pinanshu123/High-Speed-USB-2.0-Storage-Device-PCB/High-Speed USB 2.0 Storage Device PCB-Board.kicad_pcb

## KiCad design High-Speed USB 2.0 Storage Device PCB-Board.kicad_pcb (2026-09-08)

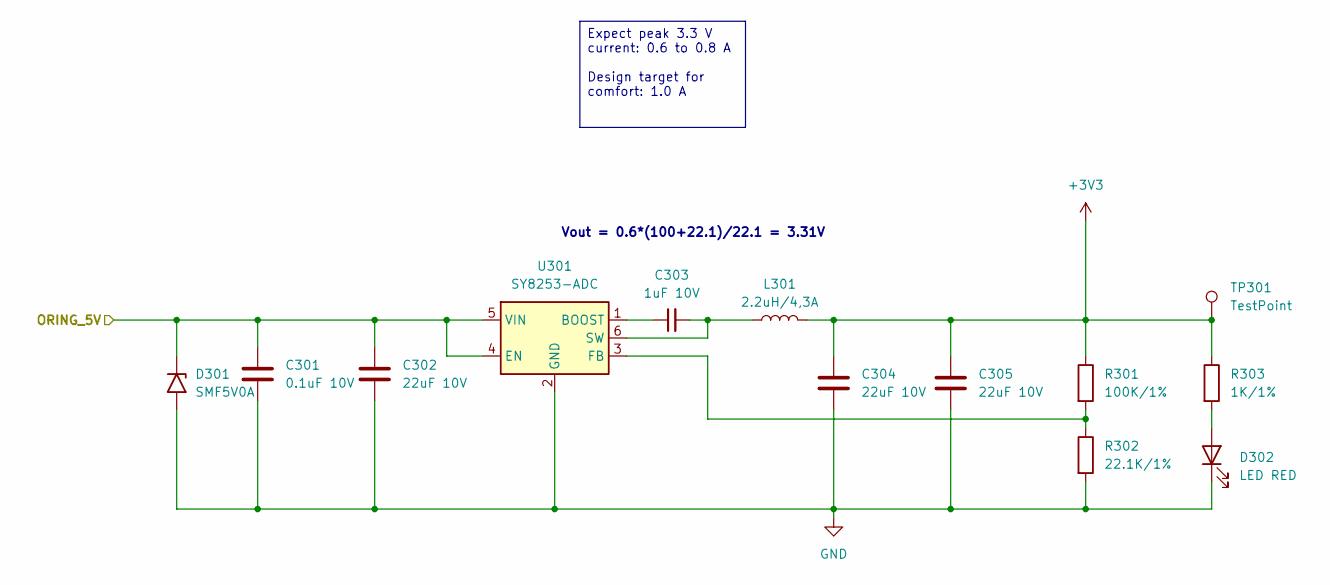
[picture p1: schematic buck_converter_power.kicad_sch, USB Smart Storage]

Parts:
C301: 0.1uF 10V; C_0402_1005Metric
C302: 22uF 10V; C_0805_2012Metric_Pad1.18x1.45mm_HandSolder
C303: 1uF 10V; C_0402_1005Metric
C304, C305: 22uF 10V; C_0805_2012Metric
D301: SMF5V0A; D_SMF
D302: LED RED; LED_0603_1608Metric
L301: 2.2uH/4,3A; L_Sunlord_SWPA4020S
R301: 100K/1%; R_01005_0402Metric
R302: 22.1K/1%; R_01005_0402Metric
R303: 1K/1%; R_01005_0402Metric
TP301: TestPoint; TestPoint_Pad_D1.5mm
U301: SY8253-ADC; TSOT-23-6

Connections:
+3V3: C304.1, C305.1, L301.2, R301.1, R303.1, TP301.1 (1_1); also elsewhere on the board
/ORING_POWER/ORING_5V: C301.1, C302.1, D301.1 (A1), U301.4 (EN), U301.5 (VIN); also elsewhere on the board
GND: C301.2, C302.2, C304.2, C305.2, D301.2 (A2), D302.1 (K), R302.2, U301.2 (GND); also elsewhere on the board
unnamed: D302.2 (A), R303.2
unnamed: C303.1, U301.1 (BOOST)
unnamed: R301.2, R302.1, U301.3 (FB)
unnamed: C303.2, L301.1, U301.6 (SW)

Notes on the sheet:
Vout = 0.6*(100+22.1)/22.1 = 3.31V
Expect peak 3.3 V current: 0.6 to 0.8 A Design target for comfort: 1.0 A

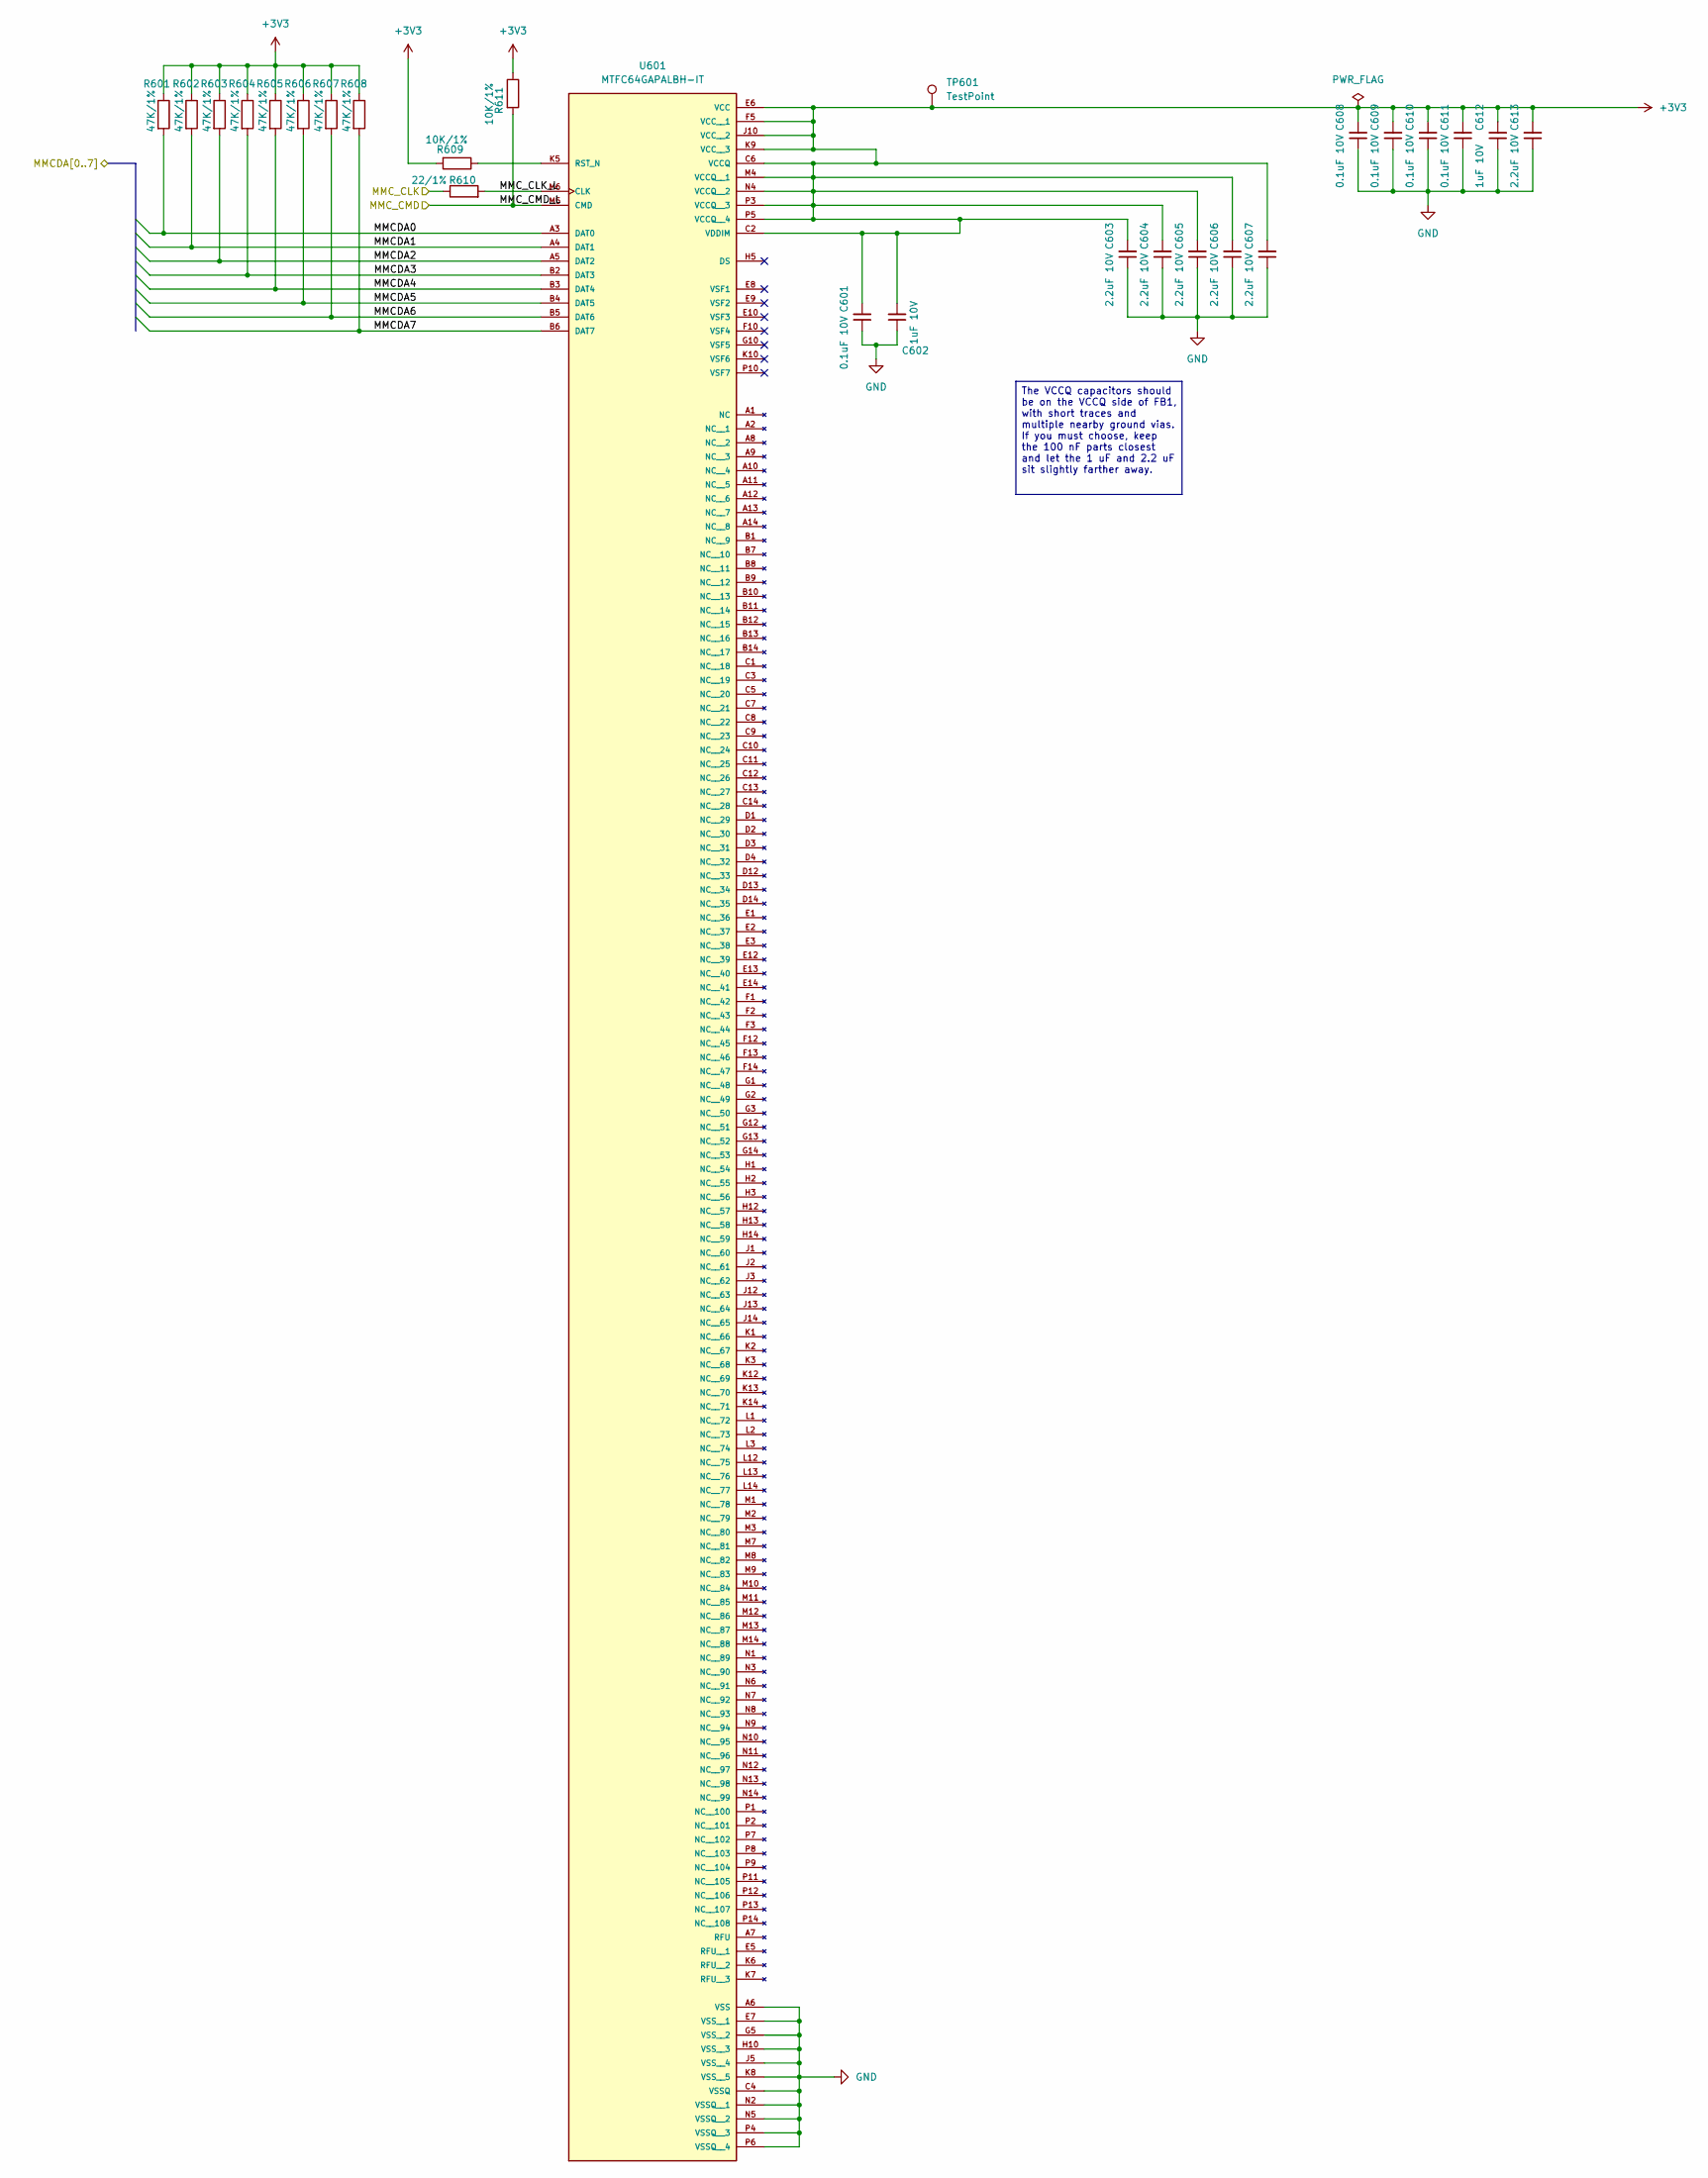
[picture p2: schematic emmc_storage.kicad_sch, USB Smart Storage]

Parts:
C601, C608, C609, C610, C611: 0.1uF 10V; C_0402_1005Metric
C602, C612: 1uF 10V; C_0402_1005Metric
C603, C604, C605, C606, C607, C613: 2.2uF 10V; C_0402_1005Metric
R601, R602, R603, R604, R605, R606, R607, R608: 47K/1%; R_01005_0402Metric
R609, R611: 10K/1%; R_01005_0402Metric
R610: 22/1%; R_01005_0402Metric
TP601: TestPoint; TestPoint_Pad_D1.5mm
U601: MTFC64GAPALBH-IT; BGA153N50P14X14_1300X1150X110N; PARTREV Rev. C 3/19 EN

Connections:
+3V3: C601.2, C602.2, C603.2, C604.2, C605.2, C606.2, C607.2, C608.2, C609.2, C610.2, C611.2, C612.2, C613.2, R601.1, R602.1, R603.1, R604.1, R605.1, R606.1, R607.1, R608.1, R609.2, R611.1, TP601.1 (1_1), U601.C2 (VDDIM), U601.C6 (VCCQ), U601.E6 (VCC), U601.F5 (VCC__1), U601.J10 (VCC__2), U601.K9 (VCC__3), U601.M4 (VCCQ__1), U601.N4 (VCCQ__2), U601.P3 (VCCQ__3), U601.P5 (VCCQ__4); also elsewhere on the board
/USB_BRIDGE/MMCD0: R601.2, U601.A3 (DAT0); also elsewhere on the board
/USB_BRIDGE/MMCD1: R602.2, U601.A4 (DAT1); also elsewhere on the board
/USB_BRIDGE/MMCD2: R603.2, U601.A5 (DAT2); also elsewhere on the board
/USB_BRIDGE/MMCD3: R604.2, U601.B2 (DAT3); also elsewhere on the board
/USB_BRIDGE/MMCD4: R605.2, U601.B3 (DAT4); also elsewhere on the board
/USB_BRIDGE/MMCD5: R606.2, U601.B4 (DAT5); also elsewhere on the board
/USB_BRIDGE/MMCD6: R607.2, U601.B5 (DAT6); also elsewhere on the board
/USB_BRIDGE/MMCD7: R608.2, U601.B6 (DAT7); also elsewhere on the board
/USB_BRIDGE/MMC_CLK: R610.1; also elsewhere on the board
/eMMC_STORAGE/MMC_CLK_L: R610.2, U601.M6 (CLK)
/eMMC_STORAGE/MMC_CMD_L: R611.2, U601.M5 (CMD); also elsewhere on the board
GND: C601.1, C602.1, C603.1, C604.1, C605.1, C606.1, C607.1, C608.1, C609.1, C610.1, C611.1, C612.1, C613.1, U601.A6 (VSS), U601.C4 (VSSQ), U601.E7 (VSS__1), U601.G5 (VSS__2), U601.H10 (VSS__3), U601.J5 (VSS__4), U601.K8 (VSS__5), U601.N2 (VSSQ__1), U601.N5 (VSSQ__2), U601.P4 (VSSQ__3), U601.P6 (VSSQ__4); also elsewhere on the board
unnamed: R609.1, U601.K5 (RST_N)

Notes on the sheet:
The VCCQ capacitors should be on the VCCQ side of FB1, with short traces and multiple nearby ground vias. If you must choose, keep the 100 nF parts closest and let the 1 uF and 2.2 uF sit slightly farther away.

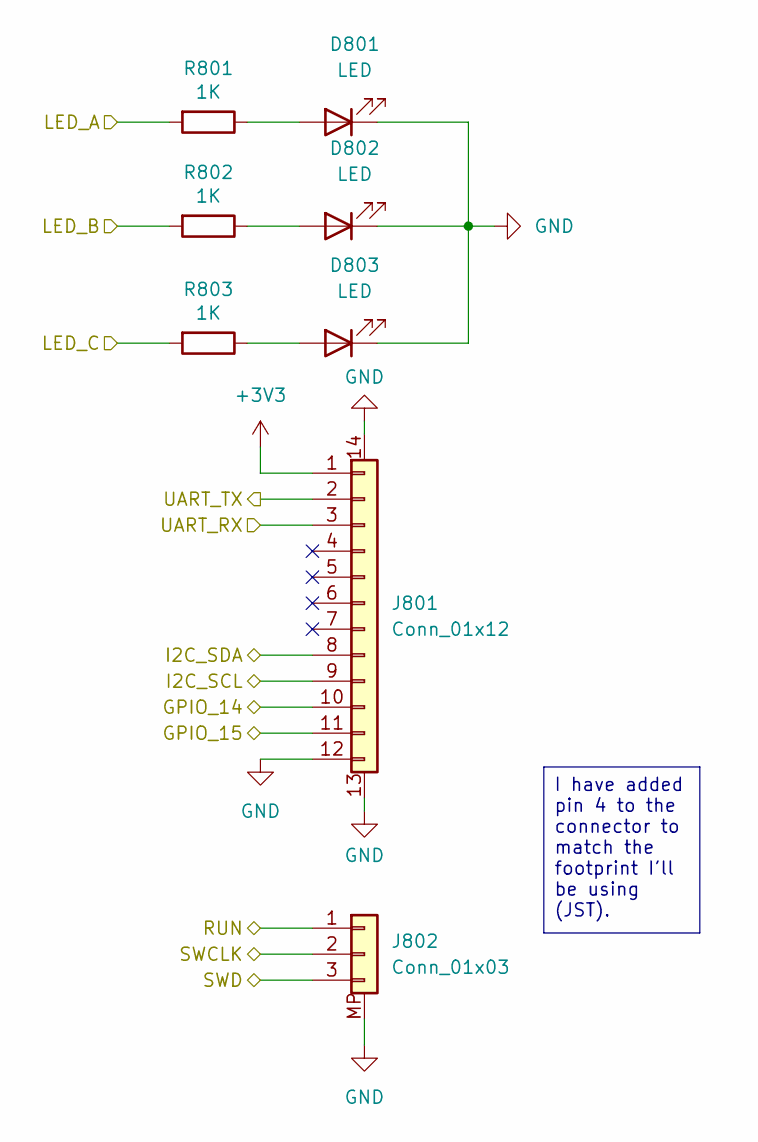
[picture p3: schematic gpio.kicad_sch, USB Smart Storage]

Parts:
D801, D802, D803: LED; LED_0603_1608Metric
J801: Conn_01x12; JST_SH_SM12B-SRSS-TB_1x12-1MP_P1.00mm_Horizontal
J802: Conn_01x03; JST_GH_SM03B-GHS-TB_1x03-1MP_P1.25mm_Horizontal
R801, R802, R803: 1K; R_0402_1005Metric

Connections:
+3V3: J801.1; also elsewhere on the board
/RP2040/GPIO_14: J801.10; also elsewhere on the board
/RP2040/GPIO_15: J801.11; also elsewhere on the board
/RP2040/I2C_SCL: J801.9; also elsewhere on the board
/RP2040/I2C_SDA: J801.8; also elsewhere on the board
/RP2040/LED_A: R801.2; also elsewhere on the board
/RP2040/LED_B: R802.2; also elsewhere on the board
/RP2040/LED_C: R803.2; also elsewhere on the board
/RP2040/RUN: J802.1; also elsewhere on the board
/RP2040/SWCLK: J802.2; also elsewhere on the board
/RP2040/SWD: J802.3; also elsewhere on the board
/RP2040/UART_RX: J801.3; also elsewhere on the board
/RP2040/UART_TX: J801.2; also elsewhere on the board
GND: D801.1 (K), D802.1 (K), D803.1 (K), J801.12, J801.13 (MP1), J801.14 (MP2), J802.MP; also elsewhere on the board
unnamed: D801.2 (A), R801.1
unnamed: D802.2 (A), R802.1
unnamed: D803.2 (A), R803.1

Notes on the sheet:
I have added pin 4 to the connector to match the footprint I'll be using (JST).

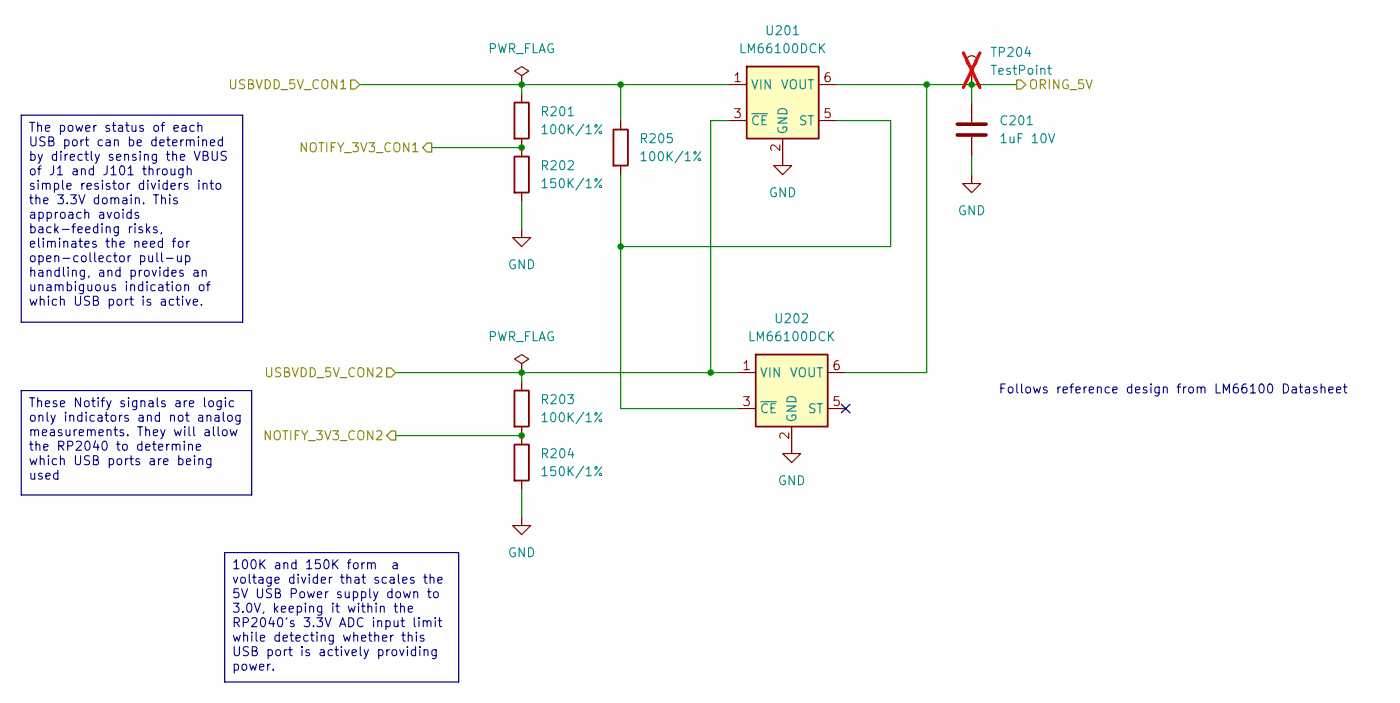
[picture p4: schematic oring_power.kicad_sch, USB Smart Storage]

Parts:
C201: 1uF 10V; C_0402_1005Metric
R201, R203, R205: 100K/1%; R_01005_0402Metric
R202, R204: 150K/1%; R_01005_0402Metric
TP204: TestPoint; TestPoint_Pad_D1.5mm; not fitted
U201, U202: LM66100DCK; SOT-363_SC-70-6

Connections:
/ORING_POWER/NOTIFY_3V3_CON1: R201.2, R202.1; also elsewhere on the board
/ORING_POWER/NOTIFY_3V3_CON2: R203.2, R204.1; also elsewhere on the board
/ORING_POWER/ORING_5V: C201.1, TP204.1, U201.6 (VOUT), U202.6 (VOUT); also elsewhere on the board
/VBUS_MCU: R203.1, U201.3 (~CE), U202.1 (VIN); also elsewhere on the board
/VBUS_STORAGE: R201.1, R205.1, U201.1 (VIN); also elsewhere on the board
GND: C201.2, R202.2, R204.2, U201.2 (GND), U202.2 (GND); also elsewhere on the board
unnamed: R205.2, U201.5 (ST), U202.3 (~CE)

Notes on the sheet:
Follows reference design from LM66100 Datasheet
100K and 150K form a voltage divider that scales the 5V USB Power supply down to 3.0V, keeping it within the RP2040's 3.3V ADC input limit while detecting whether this USB port is actively providing power.
These Notify signals are logic only indicators and not analog measurements. They will allow the RP2040 to determine which USB ports are being used
The power status of each USB port can be determined by directly sensing the VBUS of J1 and J101 through simple resistor dividers into the 3.3V domain. This approach avoids back-feeding risks, eliminates the need for open-collector pull-up handling, and provides an unambiguous indication of which US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

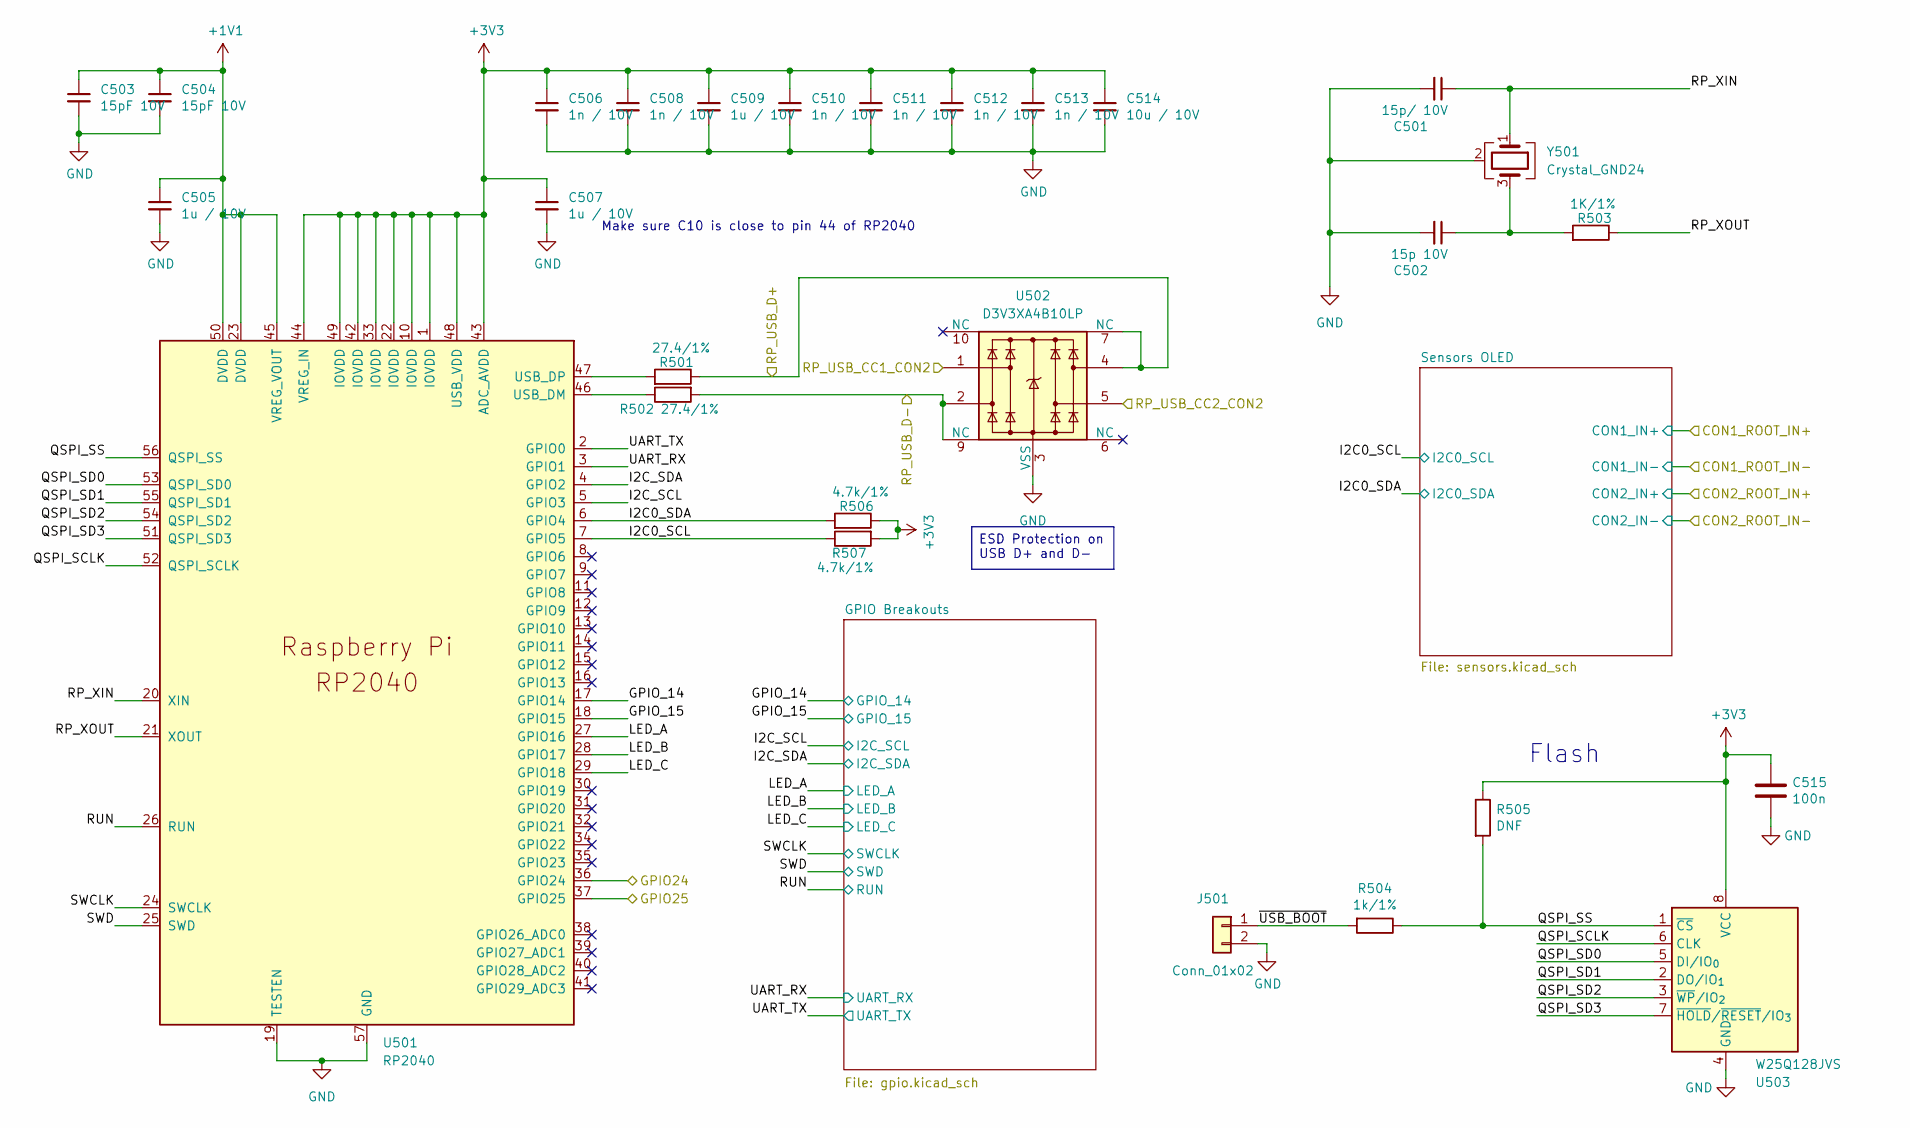
[picture p5: schematic rp2040.kicad_sch, USB Smart Storage]

Parts:
C501: 15p/ 10V; C_0402_1005Metric
C502: 15p 10V; C_0402_1005Metric
C503, C504: 15pF 10V; C_0402_1005Metric
C505, C507, C509: 1u / 10V; C_0402_1005Metric
C506, C508, C510, C511, C512, C513: 1n / 10V; C_0402_1005Metric
C514: 10u / 10V; C_0805_2012Metric
C515: 100n; C_0402_1005Metric
J501: Conn_01x02; PinHeader_1x02_P2.54mm_Vertical
R501, R502: 27.4/1%; R_01005_0402Metric
R503: 1K/1%; R_01005_0402Metric
R504: 1k/1%; R_0402_1005Metric
R505: DNF; R_0402_1005Metric
R506, R507: 4.7k/1%; R_01005_0402Metric
U501: RP2040; QFN-56-1EP_7x7mm_P0.4mm_EP3.2x3.2mm_ThermalVias
U502: D3V3XA4B10LP; Diodes_UDFN-10_1x2.5mm_P0.5mm
U503: W25Q128JVS; SOIC-8_5.3x5.3mm_P1.27mm
Y501: Crystal_GND24; Crystal_SMD_3225-4Pin_3.2x2.5mm

Connections:
+1V1: C503.1, C504.1, C505.1, U501.23 (DVDD), U501.45 (VREG_VOUT), U501.50 (DVDD)
+3V3: C506.1, C507.1, C508.1, C509.1, C510.1, C511.1, C512.1, C513.1, C514.1, C515.1, R505.1, R506.1, R507.2, U501.1 (IOVDD), U501.10 (IOVDD), U501.22 (IOVDD), U501.33 (IOVDD), U501.42 (IOVDD), U501.43 (ADC_AVDD), U501.44 (VREG_IN), U501.48 (USB_VDD), U501.49 (IOVDD), U503.8 (VCC); also elsewhere on the board
/ORING_POWER/NOTIFY_3V3_CON1: U501.37 (GPIO25); also elsewhere on the board
/ORING_POWER/NOTIFY_3V3_CON2: U501.36 (GPIO24); also elsewhere on the board
/RP2040/GPIO_14: U501.17 (GPIO14); also elsewhere on the board
/RP2040/GPIO_15: U501.18 (GPIO15); also elsewhere on the board
/RP2040/I2C0_SCL: R507.1, U501.7 (GPIO5); also elsewhere on the board
/RP2040/I2C0_SDA: R506.2, U501.6 (GPIO4); also elsewhere on the board
/RP2040/I2C_SCL: U501.5 (GPIO3); also elsewhere on the board
/RP2040/I2C_SDA: U501.4 (GPIO2); also elsewhere on the board
/RP2040/LED_A: U501.27 (GPIO16); also elsewhere on the board
/RP2040/LED_B: U501.28 (GPIO17); also elsewhere on the board
/RP2040/LED_C: U501.29 (GPIO18); also elsewhere on the board
/RP2040/QSPI_SCLK: U501.52 (QSPI_SCLK), U503.6 (CLK)
/RP2040/QSPI_SD0: U501.53 (QSPI_SD0), U503.5 (DI/IO_{0})
/RP2040/QSPI_SD1: U501.55 (QSPI_SD1), U503.2 (DO/IO_{1})
/RP2040/QSPI_SD2: U501.54 (QSPI_SD2), U503.3 (~WP/IO_{2})
/RP2040/QSPI_SD3: U501.51 (QSPI_SD3), U503.7 (~HOLD/~RESET/IO_{3})
/RP2040/QSPI_SS: R504.1, R505.2, U501.56 (QSPI_SS), U503.1 (~CS)
/RP2040/RP_USB_D+: R501.1, U502.4, U502.7 (NC); also elsewhere on the board
/RP2040/RP_USB_D-: R502.2, U502.2, U502.9 (NC); also elsewhere on the board
/RP2040/RP_XIN: C501.1, U501.20 (XIN), Y501.1
/RP2040/RP_XOUT: R503.1, U501.21 (XOUT)
/RP2040/RUN: U501.26 (RUN); also elsewhere on the board
/RP2040/SWCLK: U501.24 (SWCLK); also elsewhere on the board
/RP2040/SWD: U501.25 (SWD); also elsewhere on the board
/RP2040/UART_RX: U501.3 (GPIO1); also elsewhere on the board
/RP2040/UART_TX: U501.2 (GPIO0); also elsewhere on the board
/RP2040/~USB_BOOT: J501.1, R504.2
/USB_CC1_CON2: U502.1; also elsewhere on the board
/USB_CC2_CON2: U502.5; also elsewhere on the board
GND: C501.2, C502.2, C503.2, C504.2, C505.2, C506.2, C507.2, C508.2, C509.2, C510.2, C511.2, C512.2, C513.2, C514.2, C515.2, J501.2, U501.19 (TESTEN), U501.57 (GND), U502.3 (VSS), U502.8 (VSS), U503.4 (GND), Y501.2 (G), Y501.4 (G); also elsewhere on the board
unnamed: C502.1, R503.2, Y501.3
unnamed: R502.1, U501.46 (USB_DM)
unnamed: R501.2, U501.47 (USB_DP)

Notes on the sheet:
Flash
Make sure C10 is close to pin 44 of RP2040
ESD Protection on USB D+ and D-

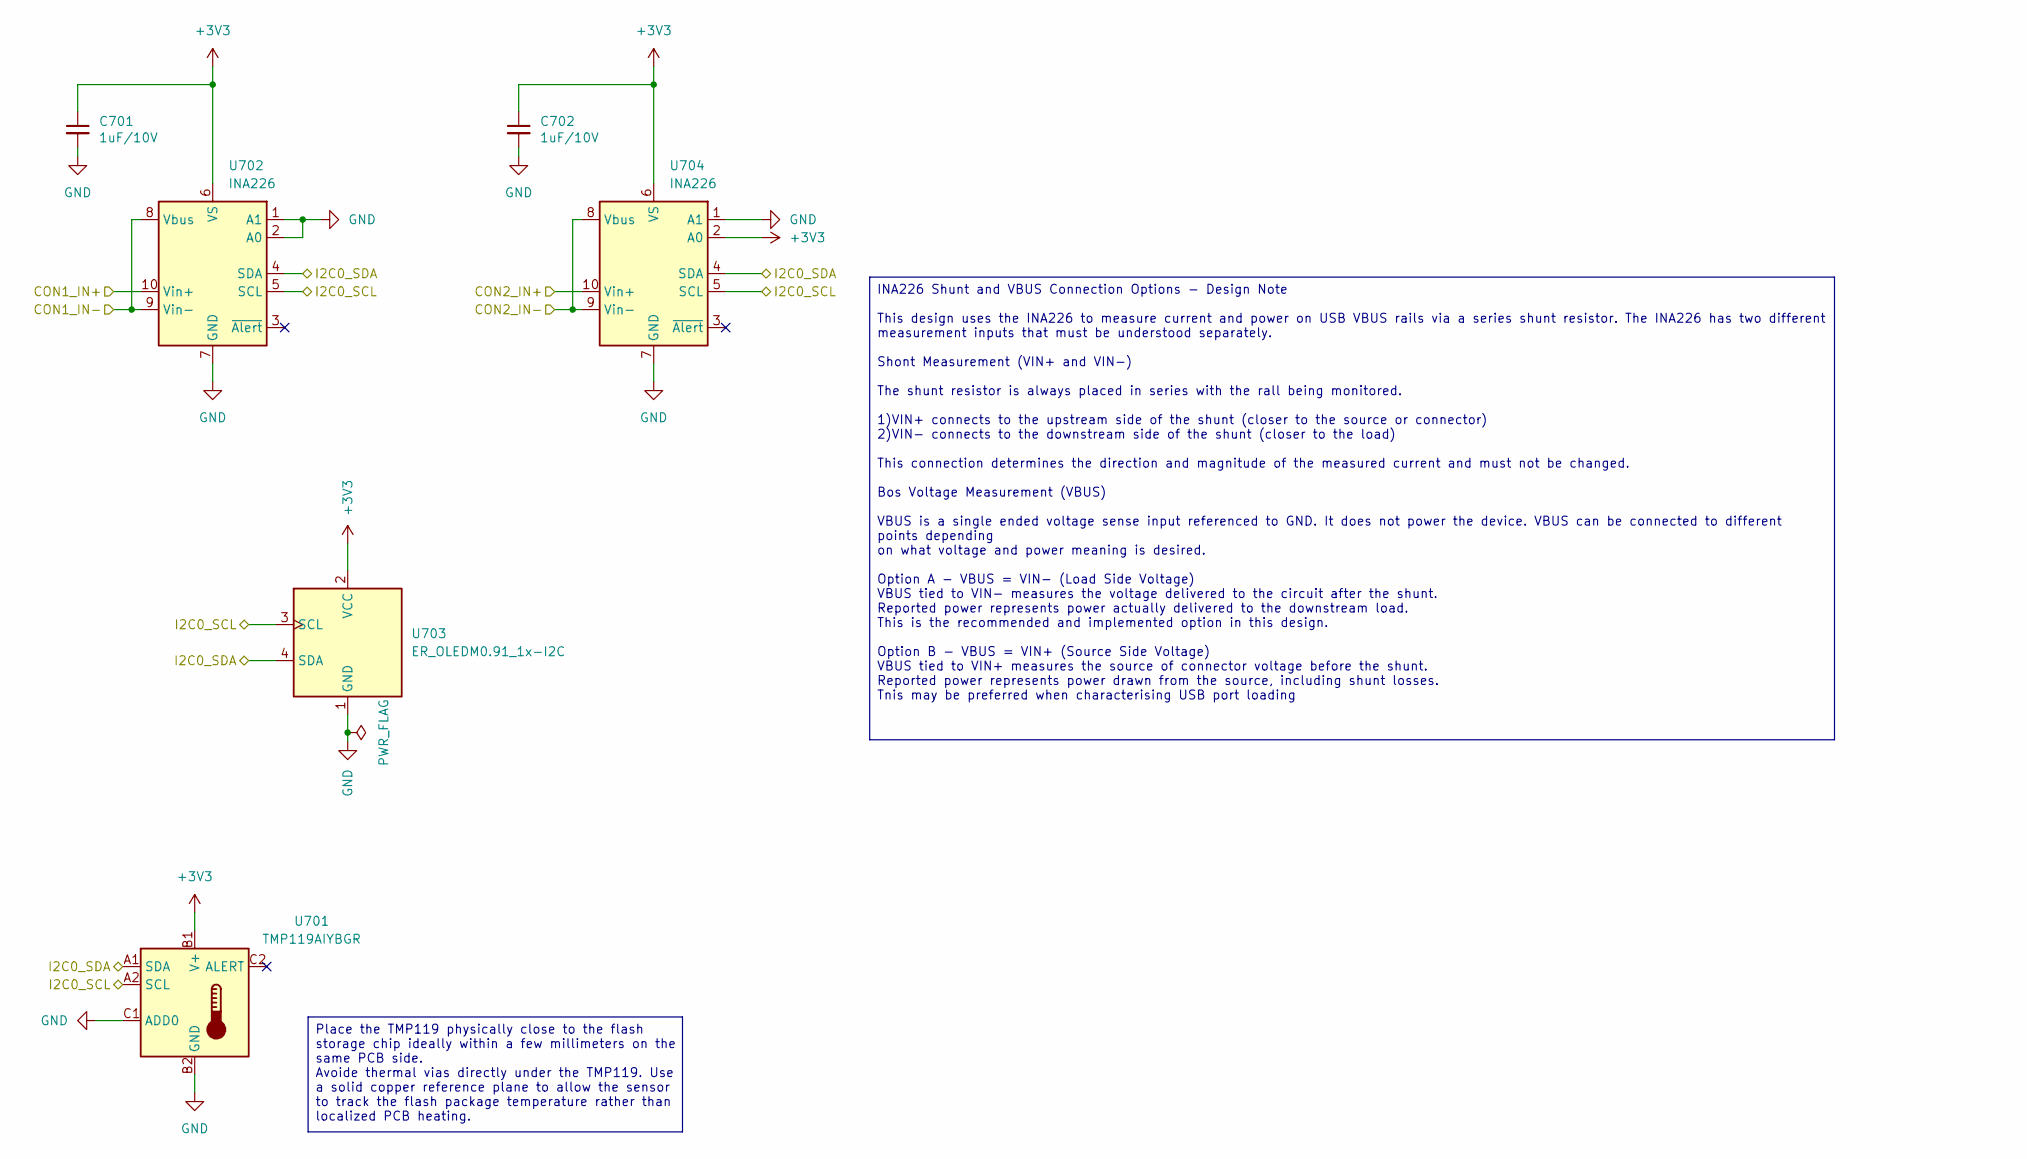
[picture p6: schematic sensors.kicad_sch, USB Smart Storage]

Parts:
C701, C702: 1uF/10V; C_0402_1005Metric
U701: TMP119AIYBGR; Texas_DSBGA-6_0.95x1.488mm_Layout2x3_P0.4mm
U702, U704: INA226; TSSOP-10_3x3mm_P0.5mm
U703: ER_OLEDM0.91_1x-I2C; SSD1306-0.91-OLED-4pin-128x32

Connections:
+3V3: C701.1, C702.1, U701.B1 (V+), U702.6 (VS), U703.2 (VCC), U704.2 (A0), U704.6 (VS); also elsewhere on the board
/RP2040/I2C0_SCL: U701.A2 (SCL), U702.5 (SCL), U703.3 (SCL), U704.5 (SCL); also elsewhere on the board
/RP2040/I2C0_SDA: U701.A1 (SDA), U702.4 (SDA), U703.4 (SDA), U704.4 (SDA); also elsewhere on the board
/VBUS_MCU_IN+: U704.10 (Vin+); also elsewhere on the board
/VBUS_MCU_IN-: U704.8 (Vbus), U704.9 (Vin-); also elsewhere on the board
/VBUS_STORAGE_IN+: U702.10 (Vin+); also elsewhere on the board
/VBUS_STORAGE_IN-: U702.8 (Vbus), U702.9 (Vin-); also elsewhere on the board
GND: C701.2, C702.2, U701.B2 (GND), U701.C1 (ADD0), U702.1 (A1), U702.2 (A0), U702.7 (GND), U703.1 (GND), U704.1 (A1), U704.7 (GND); also elsewhere on the board

Notes on the sheet:
Place the TMP119 physically close to the flash storage chip ideally within a few millimeters on the same PCB side. Avoide thermal vias directly under the TMP119. Use a solid copper reference plane to allow the sensor to track the flash package temperature rather than localized PCB heating.
INA226 Shunt and VBUS Connection Options - Design Note This design uses the INA226 to measure current and power on USB VBUS rails via a series shunt resistor. The INA226 has two different measurement inputs that must be understood separately. Shont Measurement (VIN+ and VIN-) The shunt resistor is 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

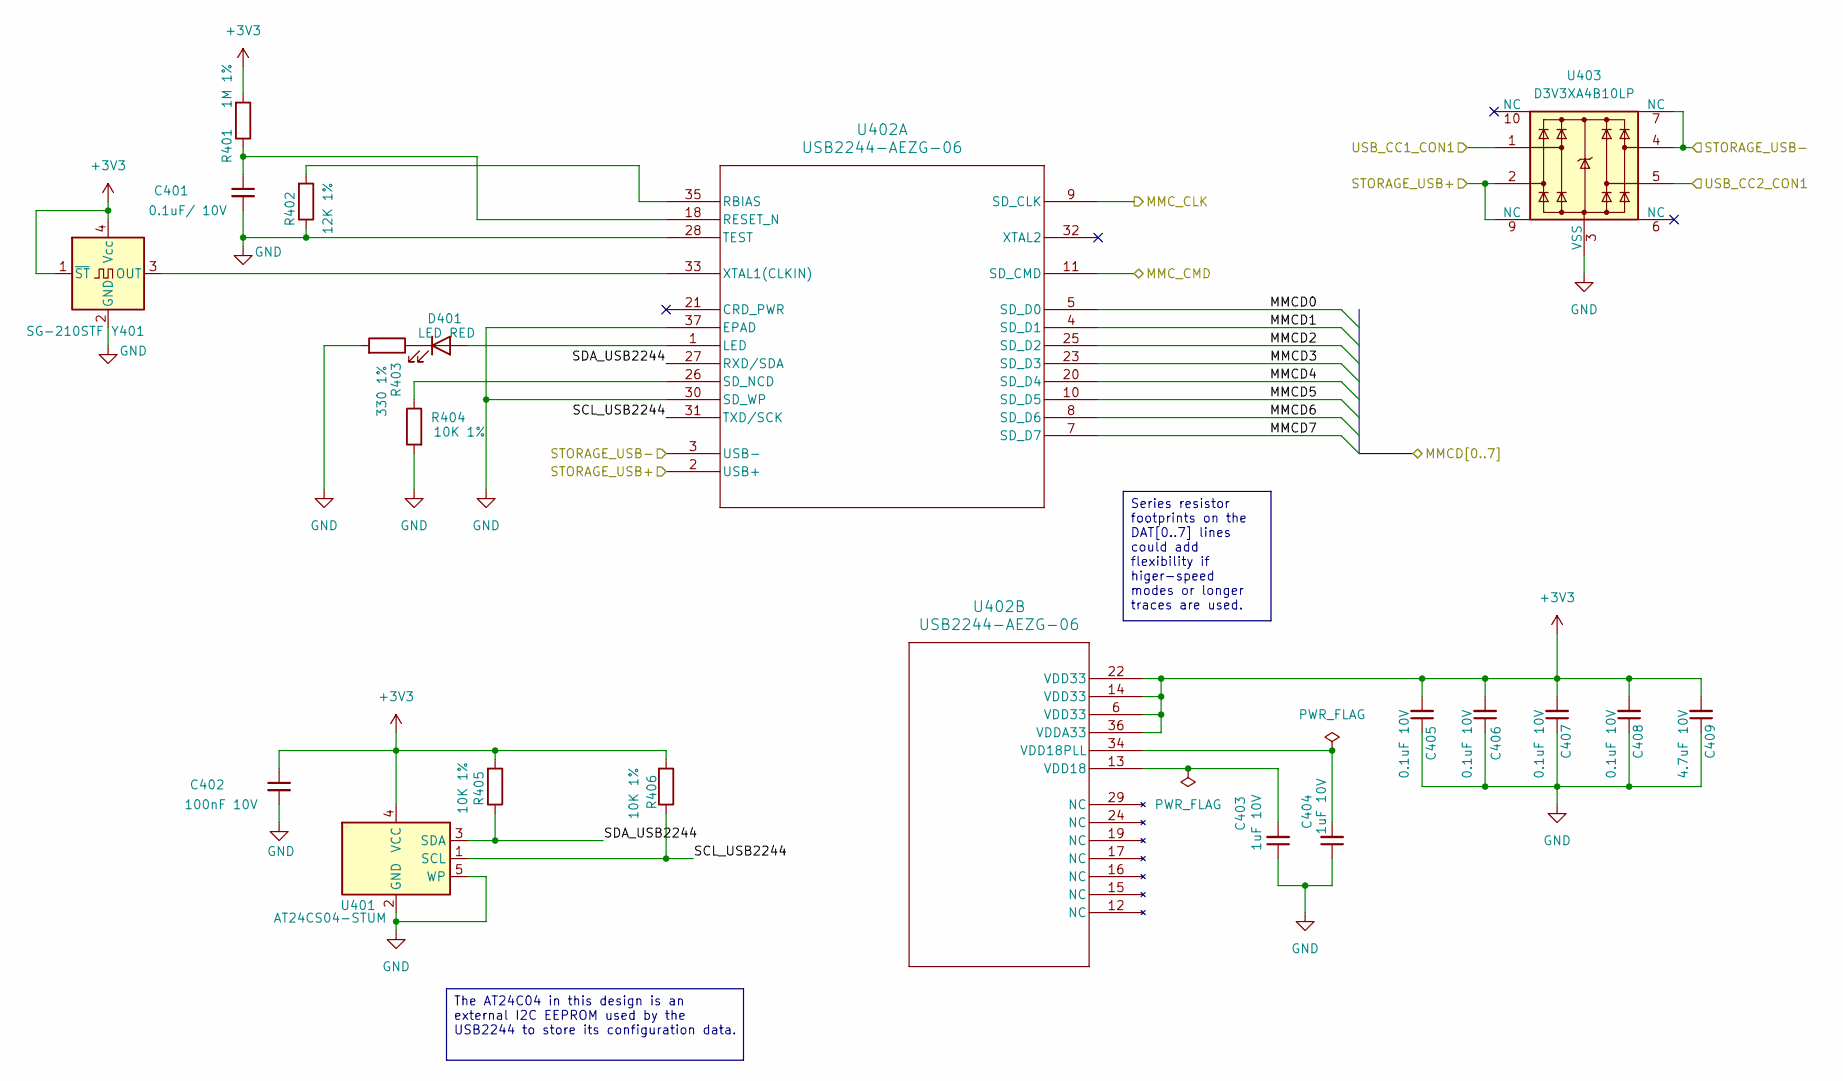
[picture p7: schematic usb_bridge.kicad_sch, USB Smart Storage]

Parts:
C401: 0.1uF/ 10V; C_0402_1005Metric
C402: 100nF 10V; C_0402_1005Metric
C403, C404: 1uF 10V; C_0402_1005Metric
C405, C406, C407, C408: 0.1uF 10V; C_0402_1005Metric
C409: 4.7uF 10V; C_0603_1608Metric
D401: LED RED; LED_0603_1608Metric
R401: 1M 1%; R_01005_0402Metric
R402: 12K 1%; R_01005_0402Metric
R403: 330 1%; R_01005_0402Metric
R404, R405, R406: 10K 1%; R_01005_0402Metric
U401: AT24CS04-STUM; SOT-23-5
U402: USB2244-AEZG-06; QFN36_6X6MC_MCH; digikey USB2244-AEZG-06-ND
U403: D3V3XA4B10LP; Diodes_UDFN-10_1x2.5mm_P0.5mm
Y401: SG-210STF; Oscillator_SMD_SeikoEpson_SG210-4Pin_2.5x2.0mm

Connections:
+3V3: C402.1, C405.2, C406.2, C407.2, C408.2, C409.2, R401.2, R405.2, R406.2, U401.4 (VCC), U402.6 (VDD33), U402.14 (VDD33), U402.22 (VDD33), U402.36 (VDDA33), Y401.1 (~ST), Y401.4 (Vcc); also elsewhere on the board
/USB_BRIDGE/MMCD0: U402.5 (SD_D0); also elsewhere on the board
/USB_BRIDGE/MMCD1: U402.4 (SD_D1); also elsewhere on the board
/USB_BRIDGE/MMCD2: U402.25 (SD_D2); also elsewhere on the board
/USB_BRIDGE/MMCD3: U402.23 (SD_D3); also elsewhere on the board
/USB_BRIDGE/MMCD4: U402.20 (SD_D4); also elsewhere on the board
/USB_BRIDGE/MMCD5: U402.10 (SD_D5); also elsewhere on the board
/USB_BRIDGE/MMCD6: U402.8 (SD_D6); also elsewhere on the board
/USB_BRIDGE/MMCD7: U402.7 (SD_D7); also elsewhere on the board
/USB_BRIDGE/MMC_CLK: U402.9 (SD_CLK); also elsewhere on the board
/USB_BRIDGE/SCL_USB2244: R406.1, U401.1 (SCL), U402.31 (TXD/SCK)
/USB_BRIDGE/SDA_USB2244: R405.1, U401.3 (SDA), U402.27 (RXD/SDA)
/USB_BRIDGE/STORAGE_USB+: U402.2 (USB+), U403.2, U403.9 (NC); also elsewhere on the board
/USB_BRIDGE/STORAGE_USB-: U402.3 (USB-), U403.4, U403.7 (NC); also elsewhere on the board
/USB_CC1_CON1: U403.1; also elsewhere on the board
/USB_CC2_CON1: U403.5; also elsewhere on the board
/eMMC_STORAGE/MMC_CMD_L: U402.11 (SD_CMD); also elsewhere on the board
GND: C401.2, C402.2, C403.1, C404.1, C405.1, C406.1, C407.1, C408.1, C409.1, R402.1, R403.2, R404.2, U401.2 (GND), U401.5 (WP), U402.28 (TEST), U402.30 (SD_WP), U402.37 (EPAD), U403.3 (VSS), U403.8 (VSS), Y401.2 (GND); also elsewhere on the board
unnamed: D401.2 (A), U402.1 (LED)
unnamed: D401.1 (K), R403.1
unnamed: R402.2, U402.35 (RBIAS)
unnamed: C401.1, R401.1, U402.18 (RESET_N)
unnamed: R404.1, U402.26 (SD_NCD)
unnamed: U402.33 (XTAL1(CLKIN)), Y401.3 (OUT)
unnamed: C403.2, U402.13 (VDD18)
unnamed: C404.2, U402.34 (VDD18PLL)

Notes on the sheet:
The AT24C04 in this design is an external I2C EEPROM used by the USB2244 to store its configuration data.
Series resistor footprints on the DAT[0..7] lines could add flexibility if higer-speed modes or longer traces are used.

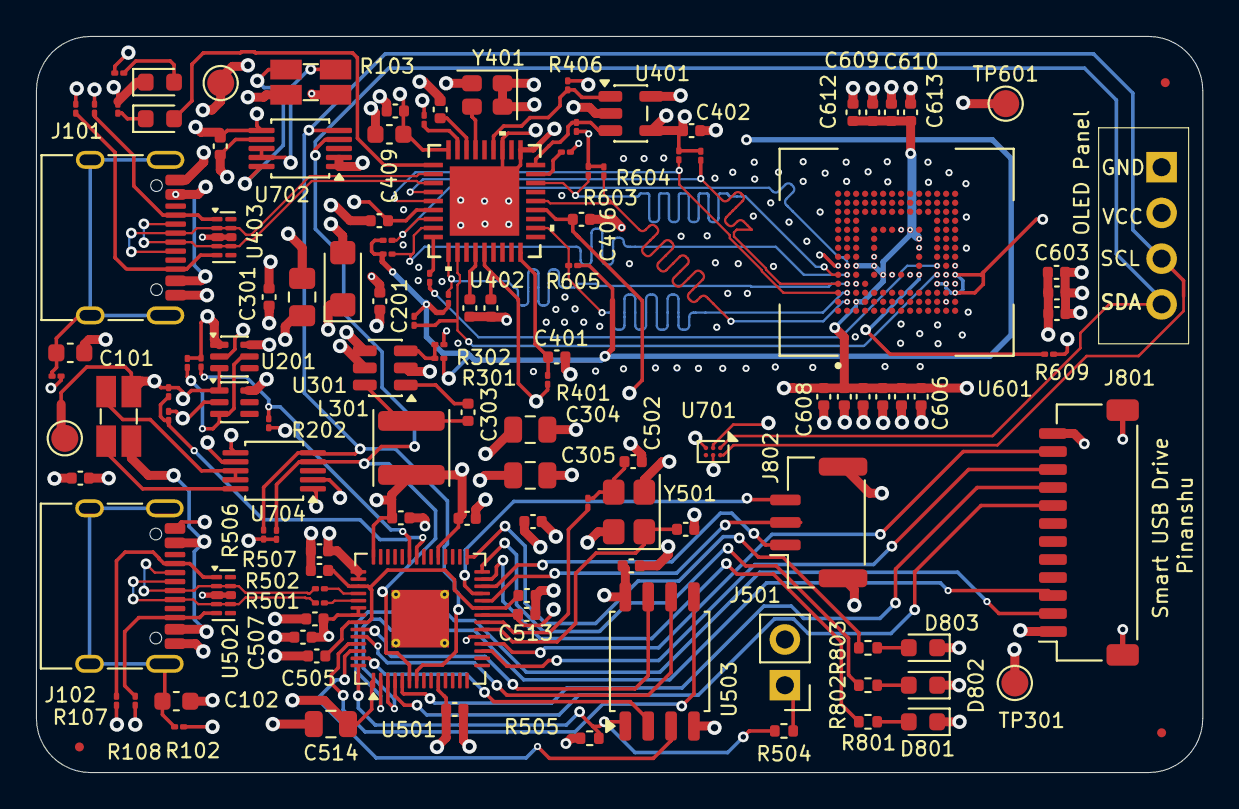
[picture p8: board High-Speed USB 2.0 Storage Device PCB-Board.kicad_pcb from above]

Board: 4 copper layers, 64.8 x 40.9 mm, 122 parts (0 on the bottom side), 80 nets.

Other parts of the board:
C101, C102: 2.2nF 100V; C_0603_1608Metric
J101, J102: USB_C_Receptacle_USB2.0_16P; USB_C_Receptacle_XKB_U262-16XN-4BVC11
R101, R102: 1M/1%; R_01005_0402Metric
R103, R104: 2m/1%; R_Shunt_Ohmite_LVK12
R105, R106: 5.5K/1%; R_01005_0402Metric
R107, R108: 2M/1%; R_01005_0402Metric
TP101, TP102: TestPoint; TestPoint_Pad_D1.5mm

Their connections:
/RP2040/RP_USB_D+: J102.A6 (D+), J102.B6 (D+); also elsewhere on the board
/RP2040/RP_USB_D-: J102.A7 (D-), J102.B7 (D-); also elsewhere on the board
/USB_BRIDGE/STORAGE_USB+: J101.A6 (D+), J101.B6 (D+); also elsewhere on the board
/USB_BRIDGE/STORAGE_USB-: J101.A7 (D-), J101.B7 (D-); also elsewhere on the board
/USB_CC1_CON1: J101.A5 (CC1), R105.1; also elsewhere on the board
/USB_CC1_CON2: J102.A5 (CC1), R107.1; also elsewhere on the board
/USB_CC2_CON1: J101.B5 (CC2), R106.1; also elsewhere on the board
/USB_CC2_CON2: J102.B5 (CC2), R108.1; also elsewhere on the board
/VBUS_MCU: R104.4, TP101.1 (1_1); also elsewhere on the board
/VBUS_MCU_IN+: R104.2; also elsewhere on the board
/VBUS_MCU_IN-: R104.3; also elsewhere on the board
/VBUS_STORAGE: R103.4, TP102.1 (1_1); also elsewhere on the board
/VBUS_STORAGE_IN+: R103.2; also elsewhere on the board
/VBUS_STORAGE_IN-: R103.3; also elsewhere on the board
GND: C101.2, C102.2, J101.A1 (GND), J101.A12 (GND), J101.B1 (GND), J101.B12 (GND), J102.A1 (GND), J102.A12 (GND), J102.B1 (GND), J102.B12 (GND), R101.2, R102.2, R105.2, R106.2, R107.2, R108.2; also elsewhere on the board
unnamed: C101.1, J101.SH (SHIELD), R101.1
unnamed: J101.A4 (VBUS), J101.A9 (VBUS), J101.B4 (VBUS), J101.B9 (VBUS), R103.1
unnamed: C102.1, J102.SH (SHIELD), R102.1
unnamed: J102.A4 (VBUS), J102.A9 (VBUS), J102.B4 (VBUS), J102.B9 (VBUS), R104.1
